rt-net/TrainingTracer_Hardware/README.md

# TrainingTracer_Hardware

[トレーニングトレーサー](https://rt-net.jp/products/rt-tracer/)
のハードウェア資料集です

tracer

## フォルダ構成

* 3d_cad_data
　トレーニングトレーサーの3DCADデータ
  STPファイルとIGSファイルで保存しています。
* 3d_print_parts
　トレーニングトレーサーの3Dプリント部品のデータ
  * TrainingTracer_Motor_Mount.stl
    トレーニングトレーサーのモータマウントの3Dモデルです。
  * TrainingTracer_Slider.stl
    トレーニングトレーサーのスライダーの3Dモデルです。
  * TrainingTracer_Wheel.stl
    トレーニングトレーサーのホイールの3Dモデルです。
* circuits
　トレーニングトレーサーの回路図とNucleoの追加工マニュアル
  * TrainingTracer_circuit.pdf
    トレーニングトレーサーのメイン基板の回路図です。
  * TrainingTracer_marker_circuit.pdf
    トレーニングトレーサーのマーカーセンサ基板の回路図です。
  * 出荷時のNucleoの追加工.pdf
    トレーニングトレーサーのNucleoボードに行った追加工の情報です。
    
## 開発について

本リポジトリはオープンソースですが、開発はオープンではありません。  
機能追加については社内のガイドラインを優先します。  
誤植や不具合の修正は常時受け付けています。詳しくは[コントリビューションガイドライン](https://github.com/rt-net/.github/blob/master/CONTRIBUTING.md)に従ってください。

## ライセンス

(C) 2020 RT Corporation \<support@rt-net.jp\>

各ファイルはライセンスがファイル中に明記されている場合、そのライセンスに従います。特に明記されていない場合は、Apache License, Version 2.0に基づき公開されています。  
ライセンスの全文は[LICENSE](./LICENSE)または[https://www.apache.org/licenses/LICENSE-2.0](https://www.apache.org/licenses/LICENSE-2.0)から確認できます。
