rt-net/TrainingTracer_Hardware/circuits/出荷時のNucleoの追加工.pdf

© 2020

# トレーニングトレーサーにおける

# Nucleoの追加工

# 本資料について

トレーニングトレーサーへNucleoを搭載するために実施した作業内容を記載していま す。別途Nucleoを購入して搭載したい場合に参照してください。

# 抵抗の加工

安全性と使いやすさを考慮して、単4アルカリ電池直列4個接続で稼働できるよう、 Nucleoに搭載の3.3Vのレギュレータを使わず、外付けのレギュータでマイコン等へ電力を 供給しています。そのため、SB14の0Ω抵抗を外す必要があります。 3.3Vを外部から入れるとST-LINKと繋がっているNRSTがずっとLOWと認識してしまい、 マイコンが起動しないので、SB9も外す必要があります。 また、アナログピンA5、A4がデータピンD5、D4に接続している状態であり、A/DとI2C が同時に使えないため、0Ω抵抗のSB16とSB18を外す必要があります。

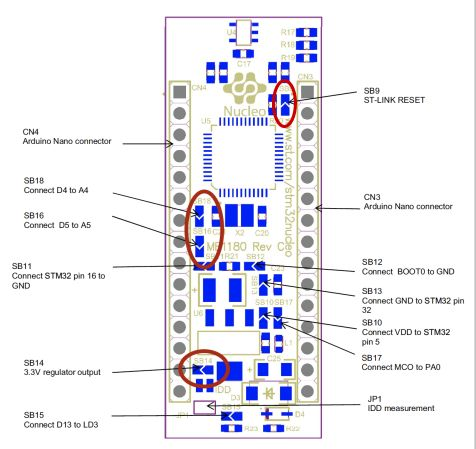
[picture p1: figure]

図.1 Nucleoボードの裏側¹

# マーカセンサについて

Nucleoのパッケージのバージョンが1.8の場合、マーカーセンサに関しては、接続されて いるピンではArduino IDEの関数がそのままでは使えないため、STEP5で機能を追加してあ ります。(パッケージのバージョンが1.9の場合は変更の必要はありません。)また、一部 Nucleoのパッケージを書き換える必要があります。NUCLEO-F303のオリジナルは、A4と D4、A5とD5がボード上で短絡しています。その関係で、A4とA5のピンに関しては、アナ ログ入力で変換できないようにパッケージ側でコメントアウトされています。プログラムを 実行する前に、テキストエディタなどでパッケージ内にある以下のファイルを修正する必要 があります。

## Windowsの場合

C:\Users\ユーザー名\ドキュメント
\ArduinoData\packages\STM32\hardware\stm32\1.8.0\variants\NUCLEO_F303K8/Pe ripheralPins.cの49と50行目のコメントアウト//を解除

## Macの場合

User/ユーザー名
/Library/Arduino15/packages/STM32/hardware/stm32/1.8.0/variants/NUCLEO_F303 K8/PeripheralPins.cの49と50行目のコメントアウト//を解除

## Linuxの場合

/home/ユーザー名
/.arduino15/packages/STM32/hardware/stm32/1.8.0/variants/NUCLEO_F303K8/Peri pheralPins.cの49と50行目のコメントアウト//を解除

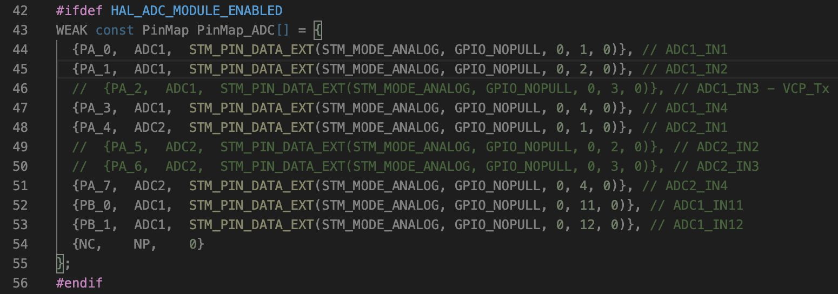
[picture p2: figure]

図.2 修正前のPeripheralPins.c

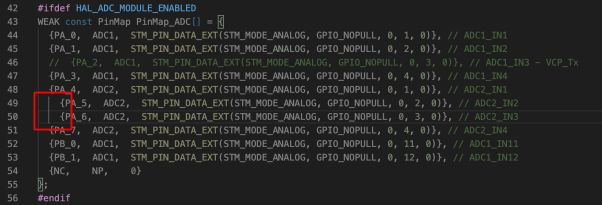
[picture p3: figure]

図.3 修正後のPeripheralPins.c

出典

1. STmicroerectronics社UM1727 User manual Getting started with STM32 Nucleo board software development tools https://www.st.com/resource/en/user_manual/dm00231744-stm32-nucleo32-boardsmb1180-stmicroelectronics.pdf (https://www.st.com/resource/en/user_manual/dm00231744-stm32-nucleo32-boards-mb1180-stmicroelectronics.pdf)
