rt-net/TrainingTracer_Hardware/3d_cad_data/TrainingTracer.igs

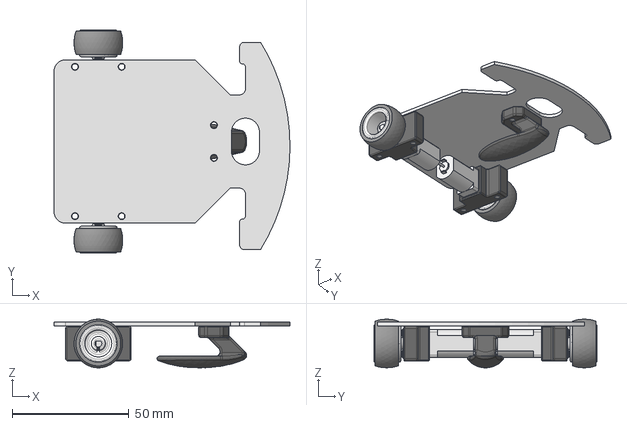
[picture p4: CAD file, 2020-07-08]
3d_cad_data/TrainingTracer.igs
101.1 x 95.6 x 20.9 mm
