rt-net/TrainingTracer_Hardware/3d_print_parts/TrainingTracer_MotorMount.stl

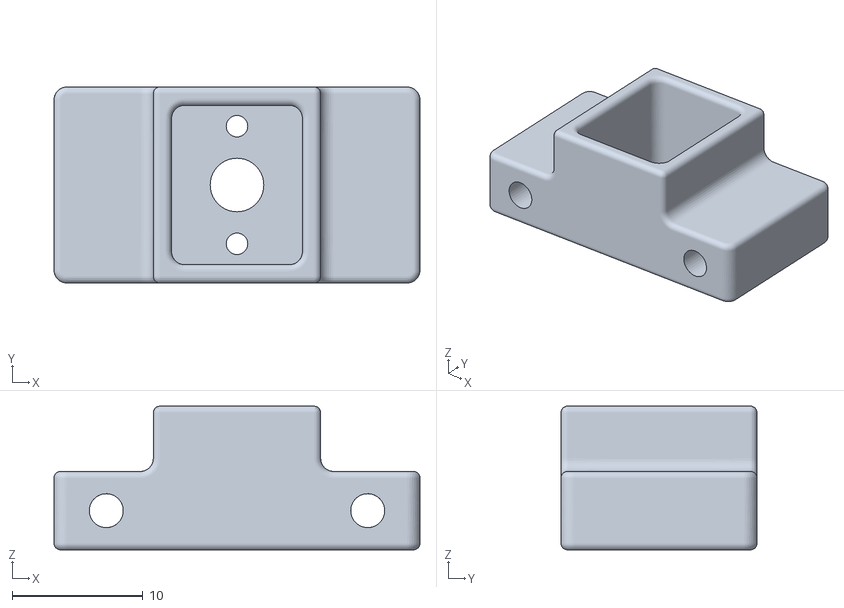
[picture p5: CAD file, 2020-07-08]
3d_print_parts/TrainingTracer_MotorMount.stl
28.0 x 15.0 x 11.0
