rt-net/TrainingTracer_Hardware/3d_print_parts/TrainingTracer_Wheel.stl

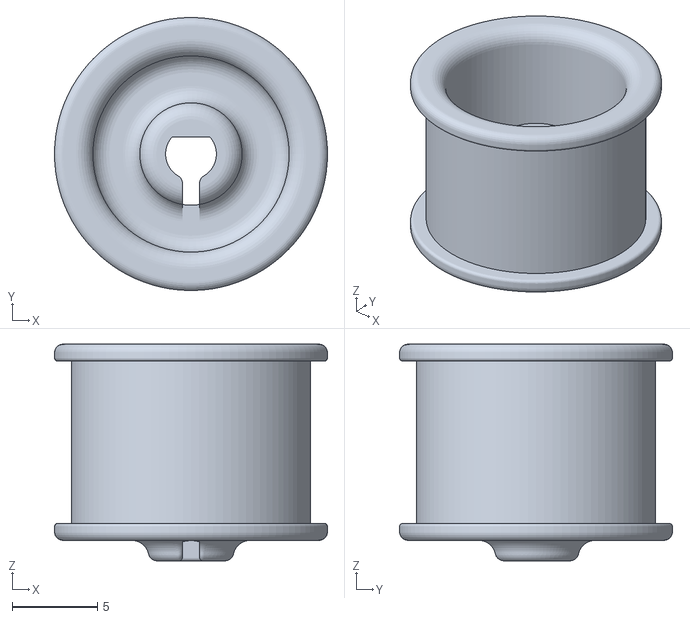
[picture p6: CAD file, 2020-07-08]
3d_print_parts/TrainingTracer_Wheel.stl
16.0 x 16.0 x 12.7
