rt-net/TrainingTracer_Hardware/3d_print_parts/TrainingTracer_Slider.stl

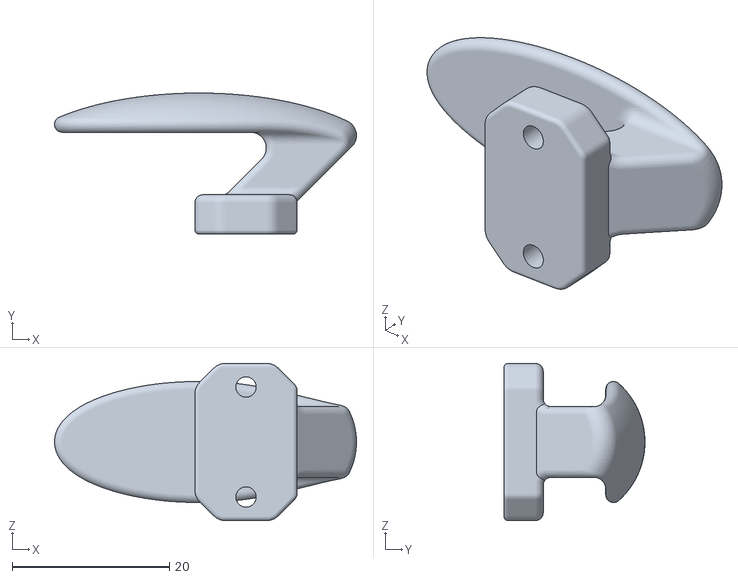
[picture p7: CAD file, 2020-07-08]
3d_print_parts/TrainingTracer_Slider.stl
38.4 x 17.9 x 20.0
