rt-net/TrainingTracer_Hardware/(list of files, cad)

Other CAD files:
3d_cad_data/TrainingTracer2020522.stp
