rt-net/TrainingTracer_Hardware/circuits/TrainingTracer_circuit.pdf

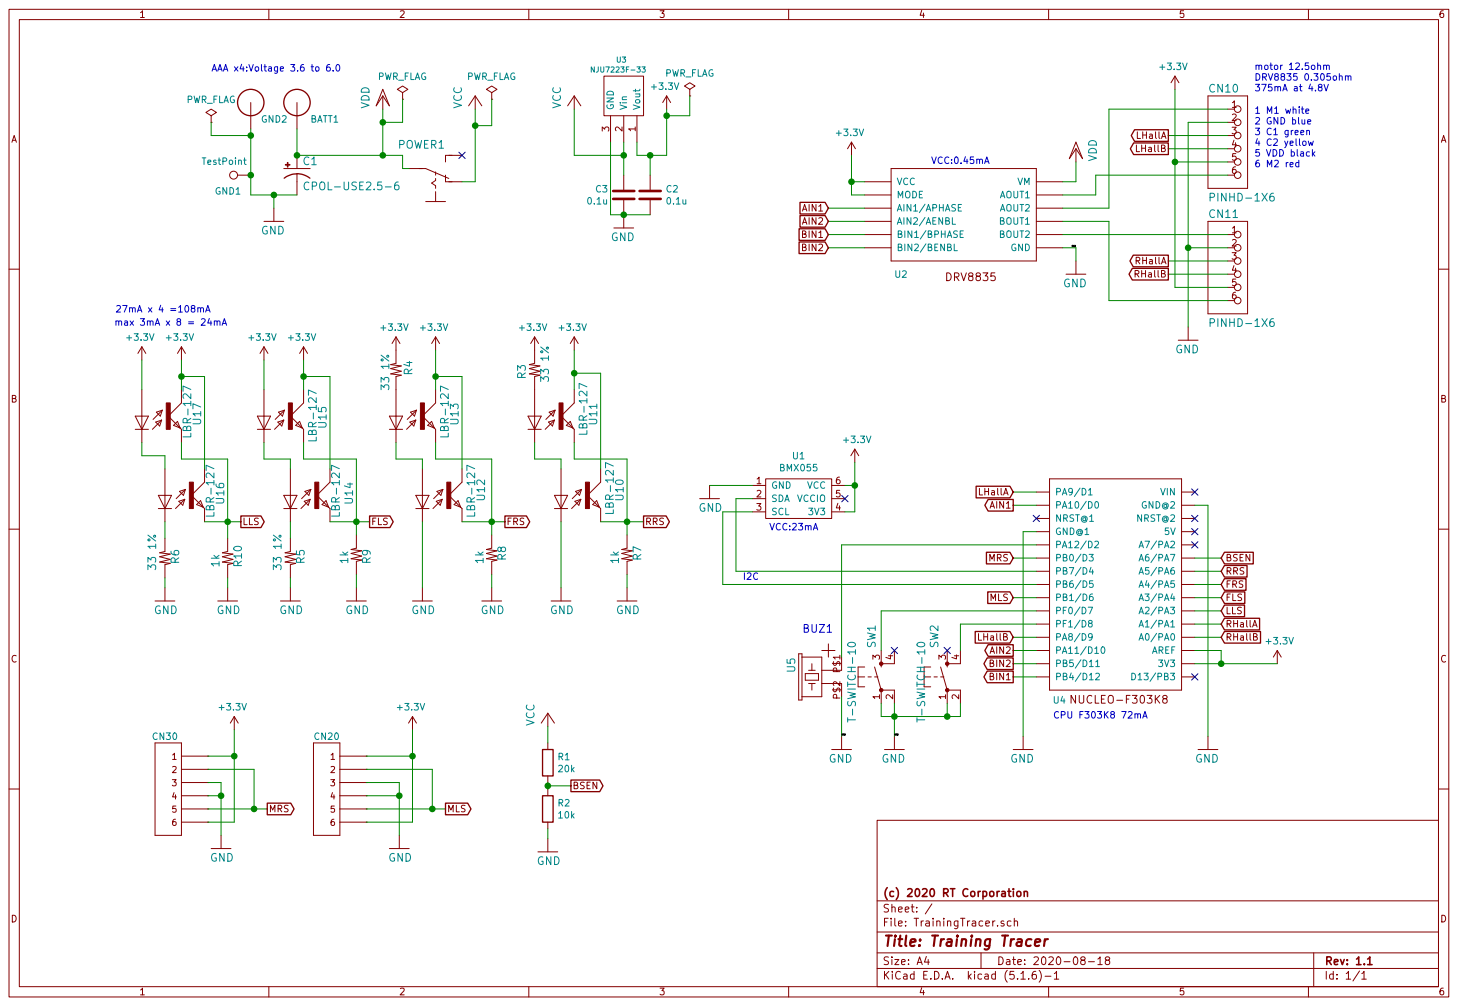
[picture p8: page 1]

4 SW1 T-SWITCH-10 GND GND VDD GND GND

5 VDD black 6 M2 red max 3mA x 8 = 24mA

File: TrainingTracer.sch Sheet: / (c) 2020 RT Corporation GND

Id: 1/1 Title: Training Tracer
