rt-net/TrainingTracer_Hardware/circuits/TrainingTracer_marker_circuit.pdf

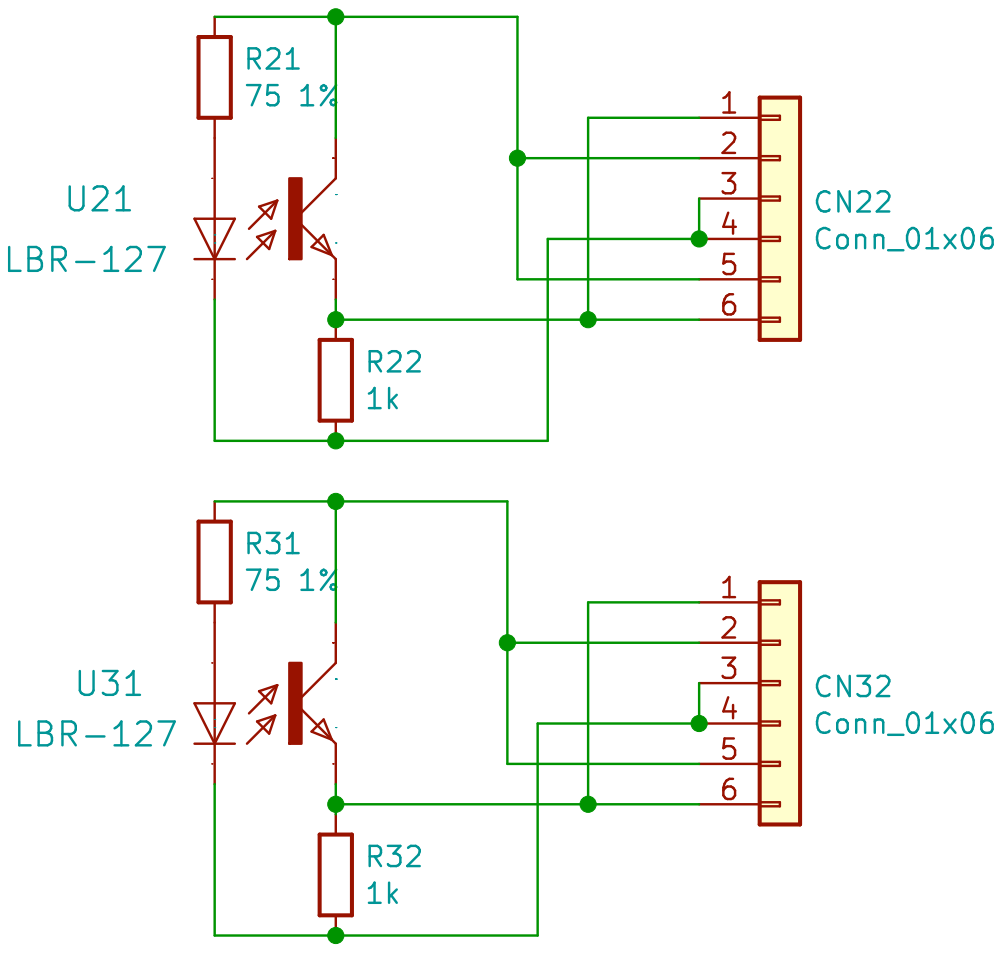
[picture p9: page 1]
