rt-net/TrainingTracer_Hardware/(commit log)

2020-07-07 Add data (#1)
    add data
    [TrainingTracer2020522.stp]
2020-07-08 Add 3D-CAD data and 3D-printing models (#2)
    * add 3d data
    * README modified
    [TrainingTracer.igs, TrainingTracer_MotorMount.stl, TrainingTracer_Slider.stl, TrainingTracer_Wheel.stl]
